tsprlng/toyota-kenwood-adaptor/(commit log)

2020-07-30 Change to high-impedance/ground signaling
2020-08-11 Clean up build now we don't have silly Arduino constraints
2020-08-16 Correct measured values for custom circuit
    [yaris.c]
2020-10-12 set fuses, and try to run podman in a less annoyingly detached way
2020-10-15 Explain power supply
